minhtenlado/STM32F407VGTx-Connect/production/bom.csv

Designator | Footprint | Quantity | Value | LCSC Part #
C1, C12, C14, C15, C16, C17, C18, C19, C20, C21, C22, C25, C4, C5, C6, C7 | 0603 | 16 | 100nF
C10, C11 | 0603 | 2 | 2.2uF
C13, C62 | 0603 | 2 | 1uF
C2, C27, C28, C3 | 0603 | 4 | 20pF
C23 | 0603 | 1 | 10uF
C24, C9 | 1206 | 2 | 22uF
C26 | 0603 | 1 | 56pF
C8 | 1206 | 1 | 10uF
D1 | 0603 | 1 | RED
D13 | 0805 | 1 | LED Red
D2 | 0603 | 1 | BLUE
D3 | D_SMA | 1 | SS34
FB1 | 0603 | 1 | FerriteBead
J1 | PinHeader_1x05_P2.54mm_Vertical | 1 | Dùng nạp cho U1
J11 | PinHeader_2x10_P2.54mm_Vertical | 1 | GPIO_D_E
J12 | PinHeader_2x10_P2.54mm_Vertical | 1 | GPIO_A_B
J13 | PinHeader_1x05_P2.54mm_Vertical | 1 | ESP32_UART0_PROG
J2 | USB_C_Receptacle_HRO_TYPE-C-31-M-12 | 1 | USB_C_Receptacle_USB2.0_16P
J3 | PinHeader_1x10_P2.54mm_Vertical | 1 | Conn_01x10_Pin
J4, J5 | PinHeader_2x10_P2.54mm_Vertical | 2 | GPIO_B_C_D
JP1, JP2 | PinHeader_1x02_P2.54mm_Vertical | 2 | Jumper_2_Open
L1 | L_Bourns_SRP5030T | 1 | 4.7uH
Q1 | SOT-23 | 1 | BC849
R1, R2 | 0603 | 2 | 100k
R10, R6 | 0603 | 2 | 100R
R11, R14, R15, R18, R19, R20, R21, R3 | 0603 | 8 | 10K
R12 | 0603 | 1 | 39K
R13 | 0603 | 1 | 1K5
R16, R17 | 0603 | 2 | 5.1K
R22 | 0603 | 1 | 93.1K
R23 | 0603 | 1 | 30.1K
R5, R7 | 0603 | 2 | 4K7
R58 | 0805 | 1 | 1K
R8 | 0603 | 1 | 200R
R9 | 0603 | 1 | 220R
S1, S2, S3 | SW_TS-1187A-B-A-B | 3 | TS-1187A-B-A-B
SW2 | SW_Slide_SPDT_Straight_CK_OS102011MS2Q | 1 | F103_USER_SW_3V3_GND
U1 | LQFP-48_7x7mm_P0.5mm | 1 | STM32F103CBTx
U2 | SOT-23-6 | 1 | USBLC6-2SC6
U3 | LQFP-100_14x14mm_P0.5mm | 1 | STM32F407VGTx
U4 | ESP32-C3-WROOM-02 | 1 | ESP32-C3-WROOM-02
U5 | SOT95P280X100-6N | 1 | AP63300WU-7
WE | //phanhuynh.id.vn/ | 1 | https://phanhuynh.id.vn/
Y1, Y2 | Crystal_SMD_ECS_CSM3X-2Pin_7.6x4.1mm | 2 | 8MHz
