minhtenlado/STM32F407VGTx-Connect/schematic.pdf

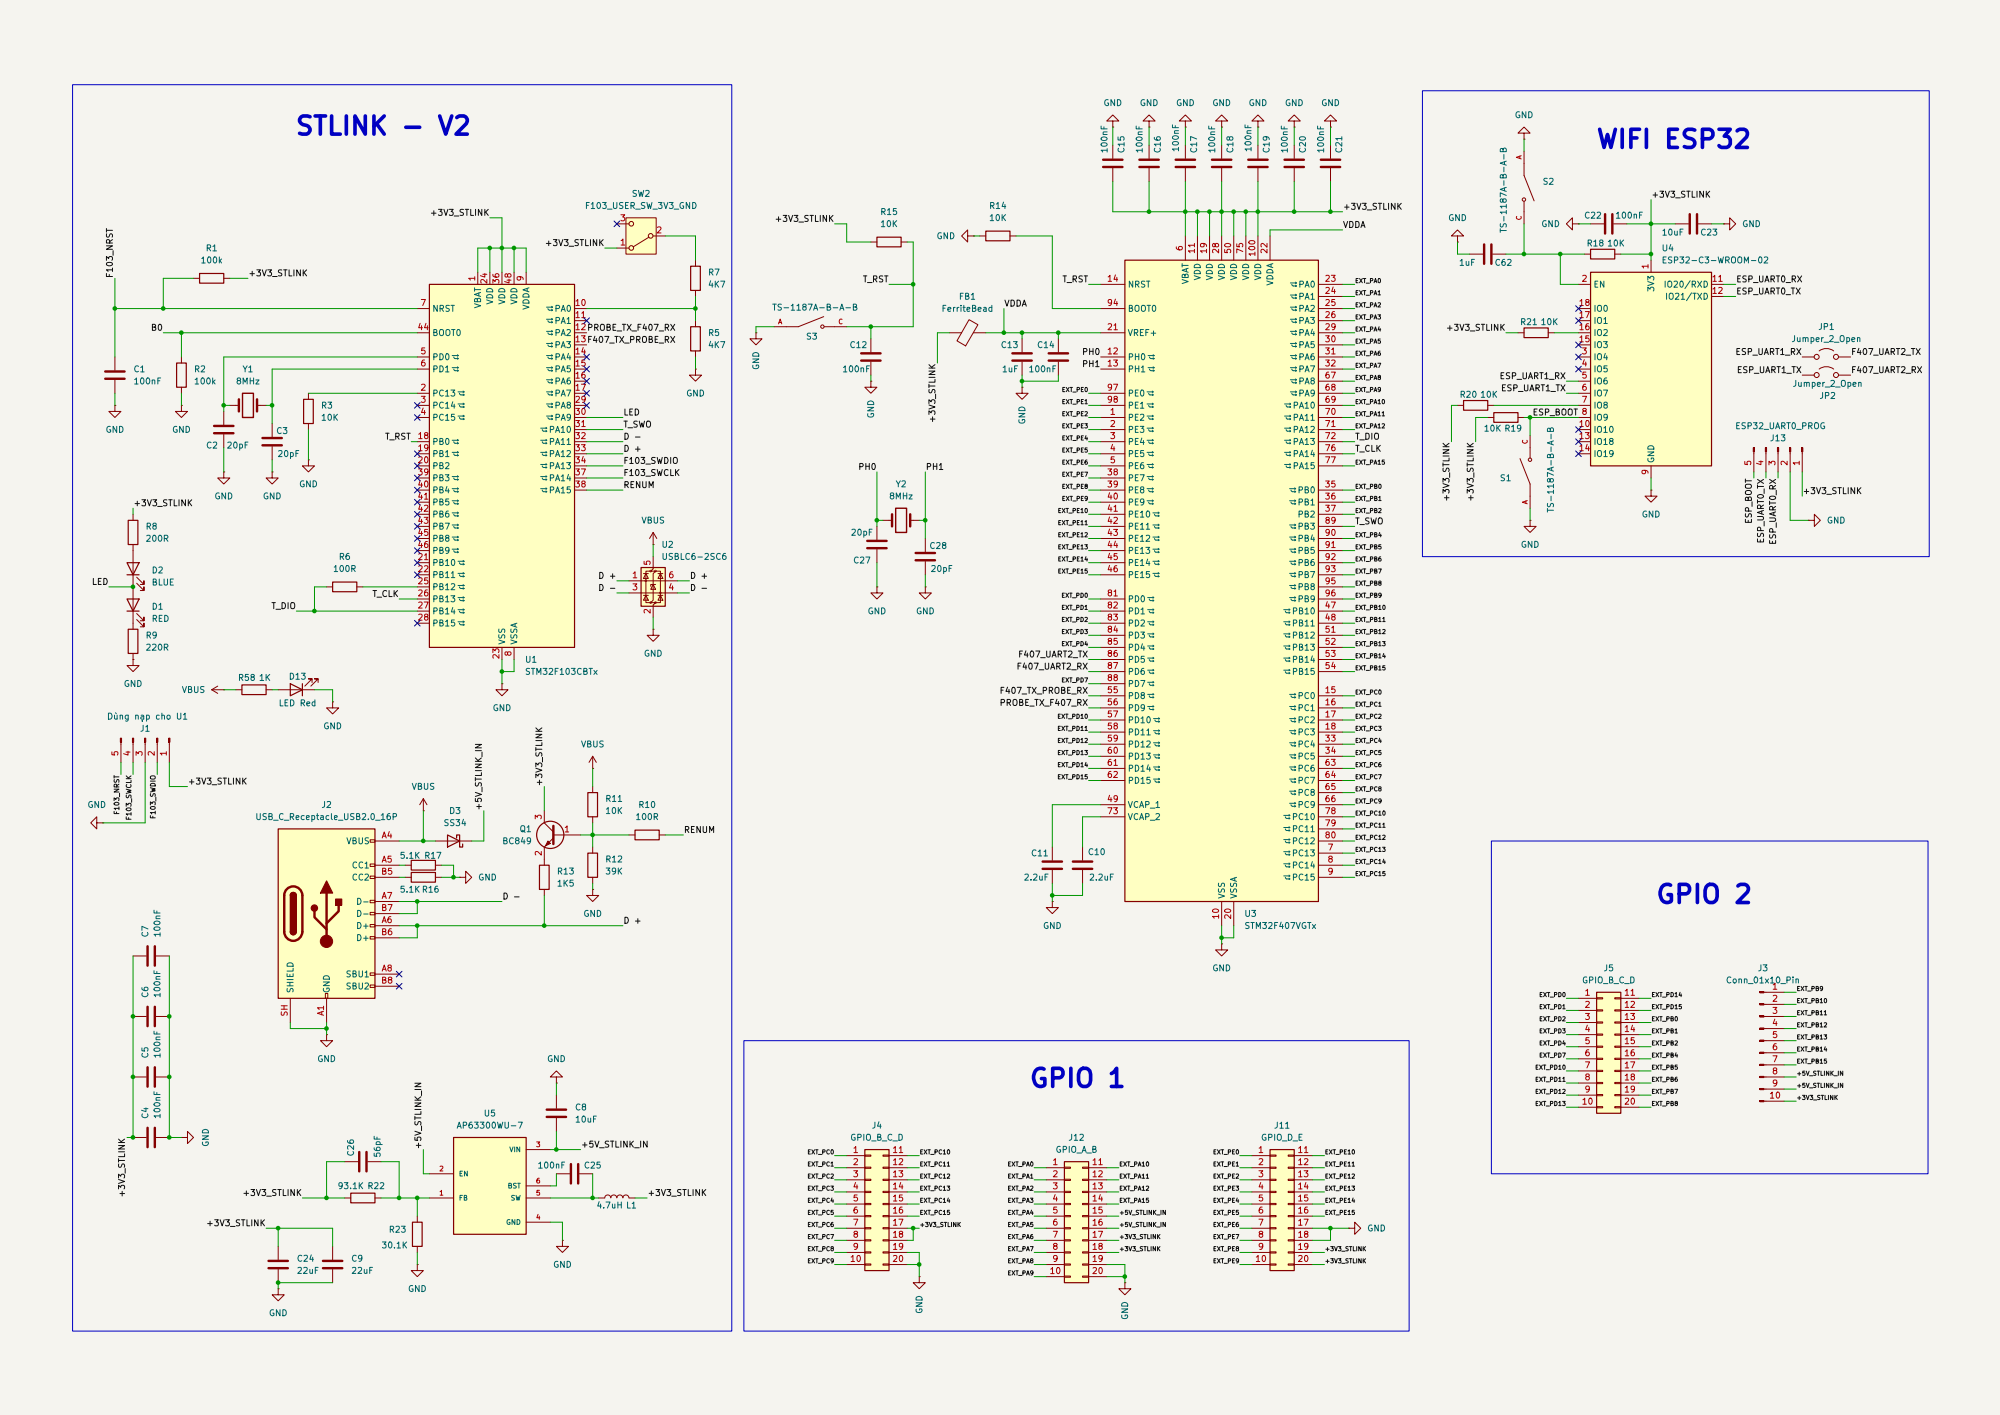
[picture p10: page 1]
