minhtenlado/STM32F407VGTx-Connect/STM32F407VGTx_wifi.kicad_pcb

## KiCad design STM32F407VGTx_wifi.kicad_pcb (2026-11-02)

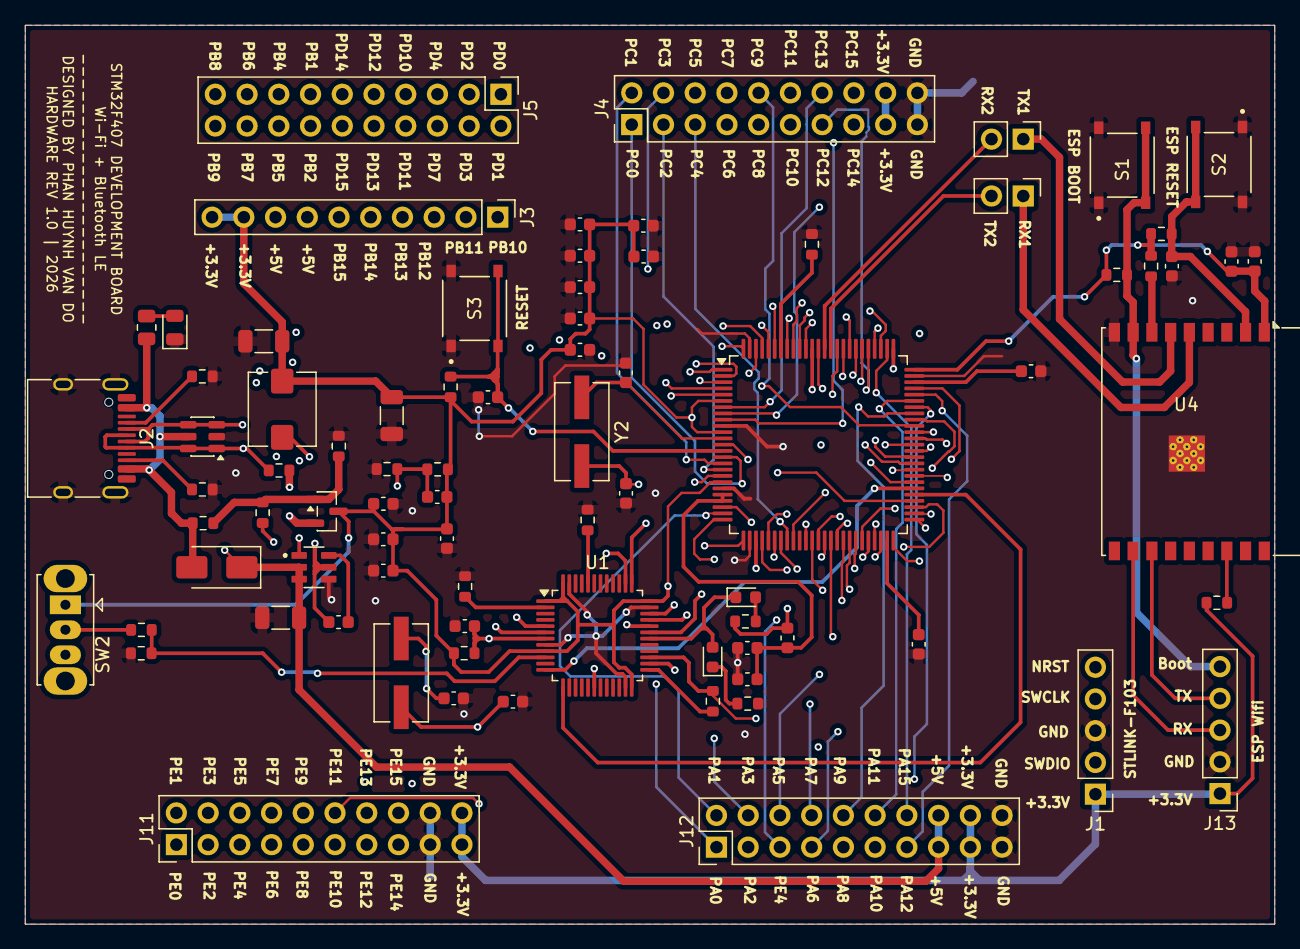
[picture p11: board STM32F407VGTx_wifi.kicad_pcb from above]

Board: 4 copper layers, 100.0 x 71.9 mm, 81 parts (1 on the bottom side), 122 nets.

Parts:
C1, C4, C5, C6, C7, C12, C14, C15, C16, C17, C18, C19, C20, C21, C22, C25: 100nF; C_0603_1608Metric
C2, C3, C27, C28: 20pF; C_0603_1608Metric
C8: 10uF; C_1206_3216Metric
C9, C24: 22uF; C_1206_3216Metric
C10, C11: 2.2uF; C_0603_1608Metric
C13, C62: 1uF; C_0603_1608Metric
C23: 10uF; C_0603_1608Metric
C26: 56pF; C_0603_1608Metric
D1: RED; LED_0603_1608Metric
D2: BLUE; LED_0603_1608Metric
D3: SS34; D_SMA
D13: LED Red; LED_0805_2012Metric
FB1: FerriteBead; L_0603_1608Metric
J1: Dùng nạp cho U1; PinHeader_1x05_P2.54mm_Vertical
J2: USB_C_Receptacle_USB2.0_16P; USB_C_Receptacle_HRO_TYPE-C-31-M-12
J3: Conn_01x10_Pin; PinHeader_1x10_P2.54mm_Vertical
J4, J5: GPIO_B_C_D; PinHeader_2x10_P2.54mm_Vertical
J11: GPIO_D_E; PinHeader_2x10_P2.54mm_Vertical
J12: GPIO_A_B; PinHeader_2x10_P2.54mm_Vertical
J13: ESP32_UART0_PROG; PinHeader_1x05_P2.54mm_Vertical
JP1, JP2: Jumper_2_Open; PinHeader_1x02_P2.54mm_Vertical
L1: 4.7uH; L_Bourns_SRP5030T
Q1: BC849; SOT-23
R1, R2: 100k; R_0603_1608Metric
R3, R11, R14, R15, R18, R19, R20, R21: 10K; R_0603_1608Metric
R5, R7: 4K7; R_0603_1608Metric
R6, R10: 100R; R_0603_1608Metric
R8: 200R; R_0603_1608Metric
R9: 220R; R_0603_1608Metric
R12: 39K; R_0603_1608Metric
R13: 1K5; R_0603_1608Metric
R16, R17: 5.1K; R_0603_1608Metric
R22: 93.1K; R_0603_1608Metric
R23: 30.1K; R_0603_1608Metric
R58: 1K; R_0805_2012Metric
S1, S2, S3: TS-1187A-B-A-B; SW_TS-1187A-B-A-B
SW2: F103_USER_SW_3V3_GND; SW_Slide_SPDT_Straight_CK_OS102011MS2Q
U1: STM32F103CBTx; LQFP-48_7x7mm_P0.5mm
U2: USBLC6-2SC6; SOT-23-6
U3: STM32F407VGTx; LQFP-100_14x14mm_P0.5mm
U4: ESP32-C3-WROOM-02
U5: AP63300WU-7; SOT95P280X100-6N
WE: https://phanhuynh.id.vn/; //phanhuynh.id.vn/
Y1, Y2: 8MHz; Crystal_SMD_ECS_CSM3X-2Pin_7.6x4.1mm

Connections:
/+3V3_STLINK: C4.2, C5.2, C6.2, C7.2, C9.2, C15.2, C16.2, C17.2, C18.2, C19.2, C20.2, C21.2, C22.1, C23.1, C24.2, C26.2, FB1.1, J1.1, J3.9, J3.10, J4.17, J4.18, J11.19, J11.20, J12.17, J12.18, J13.1, L1.2, Q1.3 (C), R1.2, R8.1, R15.2, R18.1, R19.1, R20.2, R21.2, R22.1, SW2.1 (A), U1.1 (VBAT), U1.9 (VDDA), U1.24 (VDD), U1.36 (VDD), U1.48 (VDD), U3.6 (VBAT), U3.11 (VDD), U3.19 (VDD), U3.28 (VDD), U3.50 (VDD), U3.75 (VDD), U3.100 (VDD), U4.1 (3V3)
/+5V_STLINK_IN: C8.2, D3.1 (K), J3.7, J3.8, J12.15, J12.16, U5.2 (EN), U5.3 (VIN)
/B0: R2.1, U1.44 (BOOT0)
/D +: J2.A6 (D+), J2.B6 (D+), R13.1, U1.33 (PA12), U2.1 (I/O1), U2.6 (I/O1)
/D -: J2.A7 (D-), J2.B7 (D-), U1.32 (PA11), U2.3 (I/O2), U2.4 (I/O2)
/ESP_BOOT: J13.5, R19.2, S1.C, S1.D, U4.8 (IO9)
/ESP_UART0_RX: J13.3, U4.11 (IO20/RXD)
/ESP_UART0_TX: J13.4, U4.12 (IO21/TXD)
/ESP_UART1_RX: JP1.1 (A), U4.5 (IO6)
/ESP_UART1_TX: JP2.1 (A), U4.6 (IO7)
/EXT_PA0: J12.1, U3.23 (PA0)
/EXT_PA1: J12.2, U3.24 (PA1)
/EXT_PA2: J12.3, U3.25 (PA2)
/EXT_PA3: J12.4, U3.26 (PA3)
/EXT_PA4: J12.5, U3.29 (PA4)
/EXT_PA5: J12.6, U3.30 (PA5)
/EXT_PA6: J12.7, U3.31 (PA6)
/EXT_PA7: J12.8, U3.32 (PA7)
/EXT_PA8: J12.9, U3.67 (PA8)
/EXT_PA9: J12.10, U3.68 (PA9)
/EXT_PA10: J12.11, U3.69 (PA10)
/EXT_PA11: J12.12, U3.70 (PA11)
/EXT_PA12: J12.13, U3.71 (PA12)
/EXT_PA15: J12.14, U3.77 (PA15)
/EXT_PB1: J5.13, U3.36 (PB1)
/EXT_PB2: J5.14, U3.37 (PB2)
/EXT_PB4: J5.15, U3.90 (PB4)
/EXT_PB5: J5.16, U3.91 (PB5)
/EXT_PB6: J5.17, U3.92 (PB6)
/EXT_PB7: J5.18, U3.93 (PB7)
/EXT_PB8: J5.19, U3.95 (PB8)
/EXT_PB9: J5.20, U3.96 (PB9)
/EXT_PB10: J3.1, U3.47 (PB10)
/EXT_PB11: J3.2, U3.48 (PB11)
/EXT_PB12: J3.3, U3.51 (PB12)
/EXT_PB13: J3.4, U3.52 (PB13)
/EXT_PB14: J3.5, U3.53 (PB14)
/EXT_PB15: J3.6, U3.54 (PB15)
/EXT_PC0: J4.1, U3.15 (PC0)
/EXT_PC1: J4.2, U3.16 (PC1)
/EXT_PC2: J4.3, U3.17 (PC2)
/EXT_PC3: J4.4, U3.18 (PC3)
/EXT_PC4: J4.5, U3.33 (PC4)
/EXT_PC5: J4.6, U3.34 (PC5)
/EXT_PC6: J4.7, U3.63 (PC6)
/EXT_PC7: J4.8, U3.64 (PC7)
/EXT_PC8: J4.9, U3.65 (PC8)
/EXT_PC9: J4.10, U3.66 (PC9)
/EXT_PC10: J4.11, U3.78 (PC10)
/EXT_PC11: J4.12, U3.79 (PC11)
/EXT_PC12: J4.13, U3.80 (PC12)
/EXT_PC13: J4.14, U3.7 (PC13)
/EXT_PC14: J4.15, U3.8 (PC14)
/EXT_PC15: J4.16, U3.9 (PC15)
/EXT_PD0: J5.1, U3.81 (PD0)
/EXT_PD1: J5.2, U3.82 (PD1)
/EXT_PD2: J5.3, U3.83 (PD2)
/EXT_PD3: J5.4, U3.84 (PD3)
/EXT_PD4: J5.5, U3.85 (PD4)
/EXT_PD7: J5.6, U3.88 (PD7)
/EXT_PD10: J5.7, U3.57 (PD10)
/EXT_PD11: J5.8, U3.58 (PD11)
/EXT_PD12: J5.9, U3.59 (PD12)
/EXT_PD13: J5.10, U3.60 (PD13)
/EXT_PD14: J5.11, U3.61 (PD14)
/EXT_PD15: J5.12, U3.62 (PD15)
/EXT_PE0: J11.1, U3.97 (PE0)
/EXT_PE1: J11.2, U3.98 (PE1)
/EXT_PE2: J11.3, U3.1 (PE2)
/EXT_PE3: J11.4, U3.2 (PE3)
/EXT_PE4: J11.5, U3.3 (PE4)
/EXT_PE5: J11.6, U3.4 (PE5)
/EXT_PE6: J11.7, U3.5 (PE6)
/EXT_PE7: J11.8, U3.38 (PE7)
/EXT_PE8: J11.9, U3.39 (PE8)
/EXT_PE9: J11.10, U3.40 (PE9)
/EXT_PE10: J11.11, U3.41 (PE10)
/EXT_PE11: J11.12, U3.42 (PE11)
/EXT_PE12: J11.13, U3.43 (PE12)
/EXT_PE13: J11.14, U3.44 (PE13)
/EXT_PE14: J11.15, U3.45 (PE14)
/EXT_PE15: J11.16, U3.46 (PE15)
/F103_NRST: C1.1, J1.5, R1.1, U1.7 (NRST)
/F103_SWCLK: J1.4, U1.37 (PA14)
/F103_SWDIO: J1.2, U1.34 (PA13)
/F407_TX_PROBE_RX: U1.13 (PA3), U3.55 (PD8)
/F407_UART2_RX: JP2.2 (B), U3.87 (PD6)
/F407_UART2_TX: JP1.2 (B), U3.86 (PD5)
/LED: D1.2 (A), D2.1 (K), U1.30 (PA9)
/PH0: C27.1, U3.12 (PH0), Y2.1
/PH1: C28.1, U3.13 (PH1), Y2.2
/PROBE_TX_F407_RX: U1.12 (PA2), U3.56 (PD9)
/RENUM: R10.2, U1.38 (PA15)
/T_CLK: U1.26 (PB13), U3.76 (PA14)
/T_DIO: R6.1, U1.27 (PB14), U3.72 (PA13)
/T_RST: C12.1, R15.1, S3.C, S3.D, U1.18 (PB0), U3.14 (NRST)
/T_SWO: U1.31 (PA10), U3.89 (PB3)
/VDDA: C13.1, C14.1, FB1.2, U3.21 (VREF+), U3.22 (VDDA)
GND: C1.2, C2.2, C3.2, C4.1, C5.1, C6.1, C7.1, C8.1, C9.1, C10.2, C11.2, C12.2, C13.2, C14.2, C15.1, C16.1, C17.1, C18.1, C19.1, C20.1, C21.1, C22.2, C23.2, C24.1, C27.2, C28.2, C62.1, D13.1 (K), J1.3, J2.A1 (GND), J2.A12 (GND), J2.B1 (GND), J2.B12 (GND), J2.SH (SHIELD), J4.19, J4.20, J11.17, J11.18, J12.19, J12.20, J13.2, R2.2, R3.2, R5.2, R9.2, R12.1, R14.1, R16.1, R17.1, R23.1, S1.A, S1.B, S2.A, S2.B, S3.A, S3.B, U1.8 (VSSA), U1.23 (VSS), U1.35 (VSS), U1.47 (VSS), U2.2 (GND), U3.10 (VSS), U3.20 (VSSA), U3.27 (VSS), U3.74 (VSS), U3.99 (VSS), U4.9 (GND), U4.19 (GND), U5.4 (GND)
unnamed: D1.1 (K), R9.1
unnamed: D2.2 (A), R8.2
unnamed: D13.2 (A), R58.2
unnamed: J2.A5 (CC1), R17.2
unnamed: J2.B5 (CC2), R16.2
unnamed: Q1.1 (B), R10.1, R11.1, R12.2
unnamed: Q1.2 (E), R13.2
unnamed: R7.1, SW2.2 (B)
unnamed: R5.1, R7.2, U1.10 (PA0)
unnamed: R6.2, U1.25 (PB12)
unnamed: R3.1, U1.2 (PC13)
unnamed: C2.1, U1.5 (PD0), Y1.1
unnamed: C3.1, U1.6 (PD1), Y1.2
unnamed: R14.2, U3.94 (BOOT0)
unnamed: C11.1, U3.49 (VCAP_1)
unnamed: C10.1, U3.73 (VCAP_2)
unnamed: C62.2, R18.2, S2.C, S2.D, U4.2 (EN)
unnamed: R21.1, U4.16 (IO2)
unnamed: R20.1, U4.7 (IO8)
unnamed: C25.2, U5.6 (BST)
unnamed: C26.1, R22.2, R23.2, U5.1 (FB)
unnamed: C25.1, L1.1, U5.5 (SW)
VBUS: D3.2 (A), J2.A4 (VBUS), J2.A9 (VBUS), J2.B4 (VBUS), J2.B9 (VBUS), R11.2, R58.1, U2.5 (VBUS)
