minhtenlado/STM32F407VGTx-Connect/(commit log)

2026-11-02 Add complete KiCad PCB project, firmware, images and Gerber files
2026-11-02 Update complete STM32F407 hardware project and documentation
